mt-make39/LED_Board/部品表.xlsx

品名 | サフィックス | 型式 | 個数 | スペック | 単価 | 金額 | フットプリント | URL等
電解ｺﾝ | C1,4 | 470u 16V | 2 | 470u16V | 58 | 116 |  | https://www.digikey.jp/product-detail/ja/nichicon/UWT1C471MNL1GS/493-2181-1-ND/590156
積ｾﾗ | C2,7,9-12,14-22,24-48 | 0.1u 50V | 40 | 0.1u 50V |  | 0 | 1608
電解ｺﾝ | C3,8 | 220u 16V | 2 | 220u 16V | 43 | 86 |  | https://www.digikey.jp/product-detail/ja/nichicon/UUR1C221MCL6GS/493-6214-1-ND/3438727
積ｾﾗ | C5 | 0.01u 50V | 1 | 0.01u 50V |  | 0 | 1608
積ｾﾗ | C6 | 330p 50V | 1 | 330p 50V |  | 0 | 1608
電解ｺﾝ | C13 | 4.7u 16V | 1 | 4.7u 16V | 31 | 31 |  | https://www.digikey.jp/product-detail/ja/wurth-electronics-inc/865250340002/732-8302-1-ND/5728259
積ｾﾗ | C23 | 470p 50V | 1 | 470p 50V |  | 0 | 1608
 |  |  |  |  |  | 0
ｺﾈｸﾀ | CN1 | 2*3(6pin) 表面実装 | 1 | 2*3(6pin) | 80 | 80 |  | http://akizukidenshi.com/catalog/g/gC-06098/
microUSB | CN2 |  | 1 | microUSB | 75 | 75
 |  |  |  |  |  | 0
 |  |  |  |  |  | 0
SBD | D1,3,5,6 | RB162MM-40 | 4 |  | 54 | 216 | SDO-123F | https://www.digikey.jp/product-detail/ja/rohm-semiconductor/RB162MM-40TR/RB162MM-40CT-ND/5001882
 | D4 | RB080LAM-30TR | 1 |  | 80 | 80 | SOD-128 | https://www.digikey.jp/product-detail/ja/rohm-semiconductor/RB080LAM-30TR/RB080LAM-30CT-ND/7318362
ﾂｪﾅｰﾀﾞｲｵｰﾄﾞ | D2 | KDZVTR9.1B | 1 | Vz=9.1V | 78 | 78 | SDO-123F | https://www.digikey.jp/product-detail/ja/rohm-semiconductor/KDZVTR9.1B/KDZVTR9.1BCT-ND/4931788
 |  |  |  |  |  | 0
ﾋｭｰｽﾞ | F1 | 3413.0119.22 | 1 | 2A | 54 | 54 | 3216 | https://www.digikey.jp/product-detail/ja/schurter-inc/3413.0119.22/486-1680-1-ND/2870084
 |  |  |  |  |  | 0
DCｼﾞｬｯｸ | J1 | MJ-179PH |  | ｾﾝﾀｰﾌﾟﾗｽ | 40 | 0 |  | http://akizukidenshi.com/catalog/g/gC-06568/
3.5mmｽﾃﾚｵﾐﾆ | J2 | 3.5mm_stereo_mini_ST_005_G | 1 |  | 50 | 50 |  | http://akizukidenshi.com/catalog/g/gC-02460/
 |  |  |  |  |  | 0
ｲﾝﾀﾞｸﾀ | L1 |  |  | 33u 5A以上 | 205 | 0 |  | https://www.digikey.jp/product-detail/ja/panasonic-electronic-components/ETQ-P5M330YFC/PCD2434CT-ND/5357814
 |  |  |  |  |  | 0
ﾌﾙｶﾗｰLED | LED1-25 | WS2813B | 25 |  | 30 | 750 |  | http://akizukidenshi.com/catalog/g/gI-12405/
 |  |  |  |  |  | 0
発振器 | OSC1 | SIT2001B | 1 | 16MHz | 100 | 100 |  | http://akizukidenshi.com/catalog/g/gI-11094/
 |  |  |  |  |  | 0
FET | Q1-3 | 2SJ279STL | 3 | PMOS Vds=50V以上 | 100(@50) | 100 | DPAK(SC-63) | http://akizukidenshi.com/catalog/g/gI-08267/
ﾄﾗﾝｼﾞｽﾀ | Q4 | 2SA1313 | 1 | PNP | 100(@5) | 100 | 2915 | http://akizukidenshi.com/catalog/g/gI-05554/
ﾄﾗﾝｼﾞｽﾀ | Q5 | 2SB1203 | 1 | PNP 50V5A | 200(@40) | 200 | DPAK(SC-63) | http://akizukidenshi.com/catalog/g/gI-06602/
ﾄﾗﾝｼﾞｽﾀ | Q6 | 2SC3325 | 1 | NPN | 100(@5) | 100 | 2915 | http://akizukidenshi.com/catalog/g/gI-00628/
 |  |  |  |  |  | 0
抵抗 | R1 | 0.05 2W | 1 |  | 76 | 76 | 6432 | https://www.digikey.jp/product-detail/ja/riedon/CSR2512A0R05F/696-1669-1-ND/5723657
抵抗 | R2 | 680 1/10W | 1 |  |  | 0 | 1608
抵抗 | R3,18,27,28 | 2.2k 1/10W | 4 |  |  | 0 | 1608
抵抗 | R4 | 150 1/10W | 1 |  |  | 0 | 1608
抵抗 | R5 | 330 2W | 1 |  | 82 | 82 | 6432 | https://www.digikey.jp/product-detail/ja/te-connectivity-passive-product/3521330RFT/A116020CT-ND/4279963
抵抗 | R6 | 6.2k 1/10W | 1 |  | 30 | 30 | 1608 | https://www.digikey.jp/product-detail/ja/ERJ-PB3B6201V/P20063CT-ND/6214318/?itemSeq=270788671
抵抗 | R7,9,12,17,23,26,30,31 | 10k 1/10W R26,30,31は±0.1%以下 | 8 |  | 100(@20) | #VALUE! | 1608 | http://akizukidenshi.com/catalog/g/gR-11791/
抵抗 | R8 | 15k 1/10W | 1 |  |  | 0 | 1608
抵抗 | R10 | 47k 1/10W | 1 |  |  | 0 | 1608
抵抗 | R11 | 33k 1/10W | 1 |  | 30 | 30 | 1608 | https://www.digikey.jp/product-detail/ja/ERJ-PB3B3302V/P20143CT-ND/6214398/?itemSeq=270788572
抵抗 | R13 | 11k 1/10W | 1 |  | 30 | 30 | 1608 | https://www.digikey.jp/product-detail/ja/ERJ-PB3B1102V/P20090CT-ND/6214345/?itemSeq=270788569
抵抗 | R14,19,20,24 | 22 1/10W | 4 |  |  | 0 | 1608
抵抗 | R15 | 100k 1/10W | 1 |  |  | 0 | 1608
抵抗 | R16,32,33 | 4.7k 1/10W | 3 |  |  | 0 | 1608
抵抗 | R21 | 120k ±1%以下 1/10W | 1 |  | 14 | 14 | 1608 | https://www.digikey.jp/product-detail/ja/yageo/RT0603DRE07120KL/311-2408-1-ND/6128827
抵抗 | R22 | 130k ±1%以下 1/10W | 1 |  | 22 | 22 | 1608 | https://www.digikey.jp/product-detail/ja/yageo/RT0603DRD07130KL/311-130KDCT-ND/1035693
抵抗 | R25,29 | 20k ±1%以下 1/10W | 2 |  | 22 | 44 | 1608 | https://www.digikey.jp/product-detail/ja/yageo/RT0603DRD0720KL/311-20KDCT-ND/1035742
抵抗 | R34-58 | 220 1/10W | 25 |  |  | 0 | 1608
抵抗 | R64 | 1k ±1%以下 1/10W | 1 |  | 14 | 14 | 1608 | https://www.digikey.jp/product-detail/ja/yageo/RT0603DRE071KL/311-2475-1-ND/6128894
 |  |  |  |  |  | 0
可変抵抗 | RV1 | ST4ETB104 | 1 | 100k Bｶｰﾌﾞ | 153 | 153 |  | https://www.digikey.jp/product-detail/ja/nidec-copal-electronics/ST4ETB104/ST4ETB104CT-ND/738514
 |  |  |  |  |  | 0
ﾀｸﾄｽｲｯﾁ | SW1-2 | SKHHLPA010 | 2 |  | 10 | 20 |  | http://akizukidenshi.com/catalog/g/gP-07193/
 |  |  |  |  |  | 0
ｽｲｯﾁﾝｸﾞﾚｷﾞｭﾚｰﾀ | U1 | NJM2360 | 1 |  | 75 | 75 | SOIC-8 | https://www.digikey.jp/product-detail/ja/stmicroelectronics/MC34063ECD-TR/497-7852-1-ND/1883644
ﾁｬｰｼﾞﾎﾟﾝﾌﾟIC | U2 | MAX660 | 1 |  | 192 | 192 | SOIC-8 | https://www.digikey.jp/product-detail/ja/texas-instruments/MAX660MX-NOPB/MAX660MX-NOPBCT-ND/3527164
ﾘｾｯﾄIC | U3 | TCM809 | 1 |  | 200(@25) | 200 | SC-70(2125) | http://akizukidenshi.com/catalog/g/gI-02709/
USBｼﾘｱﾙ変換 | U4 | FT232RL | 1 |  | 400 | 400 | SSOP-28 | http://akizukidenshi.com/catalog/g/gI-01739/
ﾘﾌｧﾚﾝｽIC | U5 | NJM2825 | 1 |  | 140 | 140 | SOT-23-5(MPT5) | http://akizukidenshi.com/catalog/g/gI-08952/
ｵﾍﾟｱﾝﾌﾟ | U6-7 | NJM072B | 2 |  | 65 | 130 | SOIC-8 | https://www.digikey.jp/product-detail/ja/texas-instruments/LF353DR/296-14587-1-ND/555562
AVRﾏｲｺﾝ | U8 | ATmega328P-AU | 1 |  | 230 | 230 | TQFP-32 | http://akizukidenshi.com/catalog/g/gI-04386/
 |  |  |  |  |  | 0
 |  |  |  |  |  | 0
 |  |  |  |  |  | 0
 |  |  |  |  |  | 0
 |  |  |  |  |  | #VALUE!
