mt-make39/LED_Board/LED_Board.xlsx

Part | Footprint | Value | Number | Reference
AVR-ISP-6 |  | 3pin*2 | 1 | J2
C | C_SMD:C_1608 | 0.01u | 1 | C5
C | C_SMD:C_1608 | 0.1u | 40 | C19, C47, C31, C30, C34, C29, C28, C35, C46, C27, C26, C36, C45, C25, C24, C37, C22, C20, C21, C38, C7, C44, C39, C40, C2, C41, C14, C16, C15, C18, C32, C10, C11, C33, C43, C9, C17, C12, C42, C48
C | C_SMD:C_1608 | 330p | 1 | C6
C | C_SMD:C_1608 | 470p | 1 | C23
CP1 |  | 220u 16V | 2 | C8, C3
CP1 |  | 4.7u 16V | 1 | C13
CP1 |  | 470u 16V | 2 | C4, C1
D |  | D | 5 | D1, D4, D6, D3, D5
D_Zener |  | Vz=9.1V | 1 | D2
2SC1815 |  | npn | 1 | Q6
Q_PMOS_GDS |  | pmos | 3 | Q3, Q2, Q1
2SA1015 |  | pnp | 1 | Q4
Q_PNP_BCE |  | Icc=5A | 1 | Q5
R |  | 0.05 2W | 1 | R1
R |  | 220 2W | 1 | R5
R | R_SMD:R_1608 | 100k | 1 | R15
R | R_SMD:R_1608 | 10k | 8 | R31, R7, R17, R30, R26, R12, R9, R23
R | R_SMD:R_1608 | 110 | 1 | R4
R | R_SMD:R_1608 | 11k | 1 | R13
R | R_SMD:R_1608 | 120k | 1 | R21
R | R_SMD:R_1608 | 131k | 1 | R22
R | R_SMD:R_1608 | 15k | 1 | R8
R | R_SMD:R_1608 | 2.2k | 4 | R27, R3, R18, R28
R | R_SMD:R_1608 | 20k | 2 | R29, R25
R | R_SMD:R_1608 | 22 | 4 | R20, R14, R19, R24
R | R_SMD:R_1608 | 220 | 25 | R34, R46, R57, R35, R48, R52, R36, R45, R55, R37, R54, R53, R38, R44, R50, R39, R51, R49, R40, R43, R47, R41, R58, R56, R42
R | R_SMD:R_1608 | 33k | 1 | R11
R | R_SMD:R_1608 | 4.7k | 3 | R33, R16, R32
R | R_SMD:R_1608 | 47k | 1 | R10
R | R_SMD:R_1608 | 6.2k | 1 | R6
R | R_SMD:R_1608 | 680 | 1 | R2
R_POT |  | 100k | 1 | RV1
ATMEGA328P-A-RESCUE-LED_Board | TQFP32 | ATMEGA328P-A | 1 | U?
FT232RL |  | FT232RL | 1 | U4
F_Small |  | 2A | 1 | F1
SW_PUSH |  | SW_PUSH | 1 | SW1
WS2813 |  | WS2813 | 25 | LED14, LED1, LED10, LED15, LED8, LED25, LED16, LED11, LED7, LED17, LED6, LED12, LED9, LED24, LED5, LED19, LED23, LED4, LED20, LED13, LED3, LED21, LED2, LED22, LED18
SIT2001B |  | 16MHz | 1 | OSC1
MAX660 |  | MAX660 | 1 | U2
NJM2360 |  | NJM2360 | 1 | U1
TCM809 |  | TCM809 | 1 | U3
NJM2825 |  | NJM2825 | 1 | U5
3.5mm_stereo_mini_ST_005_G |  | 3.5mm_stereo_mini_ST_005_G | 1 | J3
BARREL_JACK |  | BARREL_JACK | 1 | J1
USB_OTG |  | microUSB | 1 | P1
NJM072 |  | NJM072 | 2 | U6, U7
INDUCTOR |  | 33u 5A | 1 | L1
