mt-make39/LED_Board/LED_Board.pdf

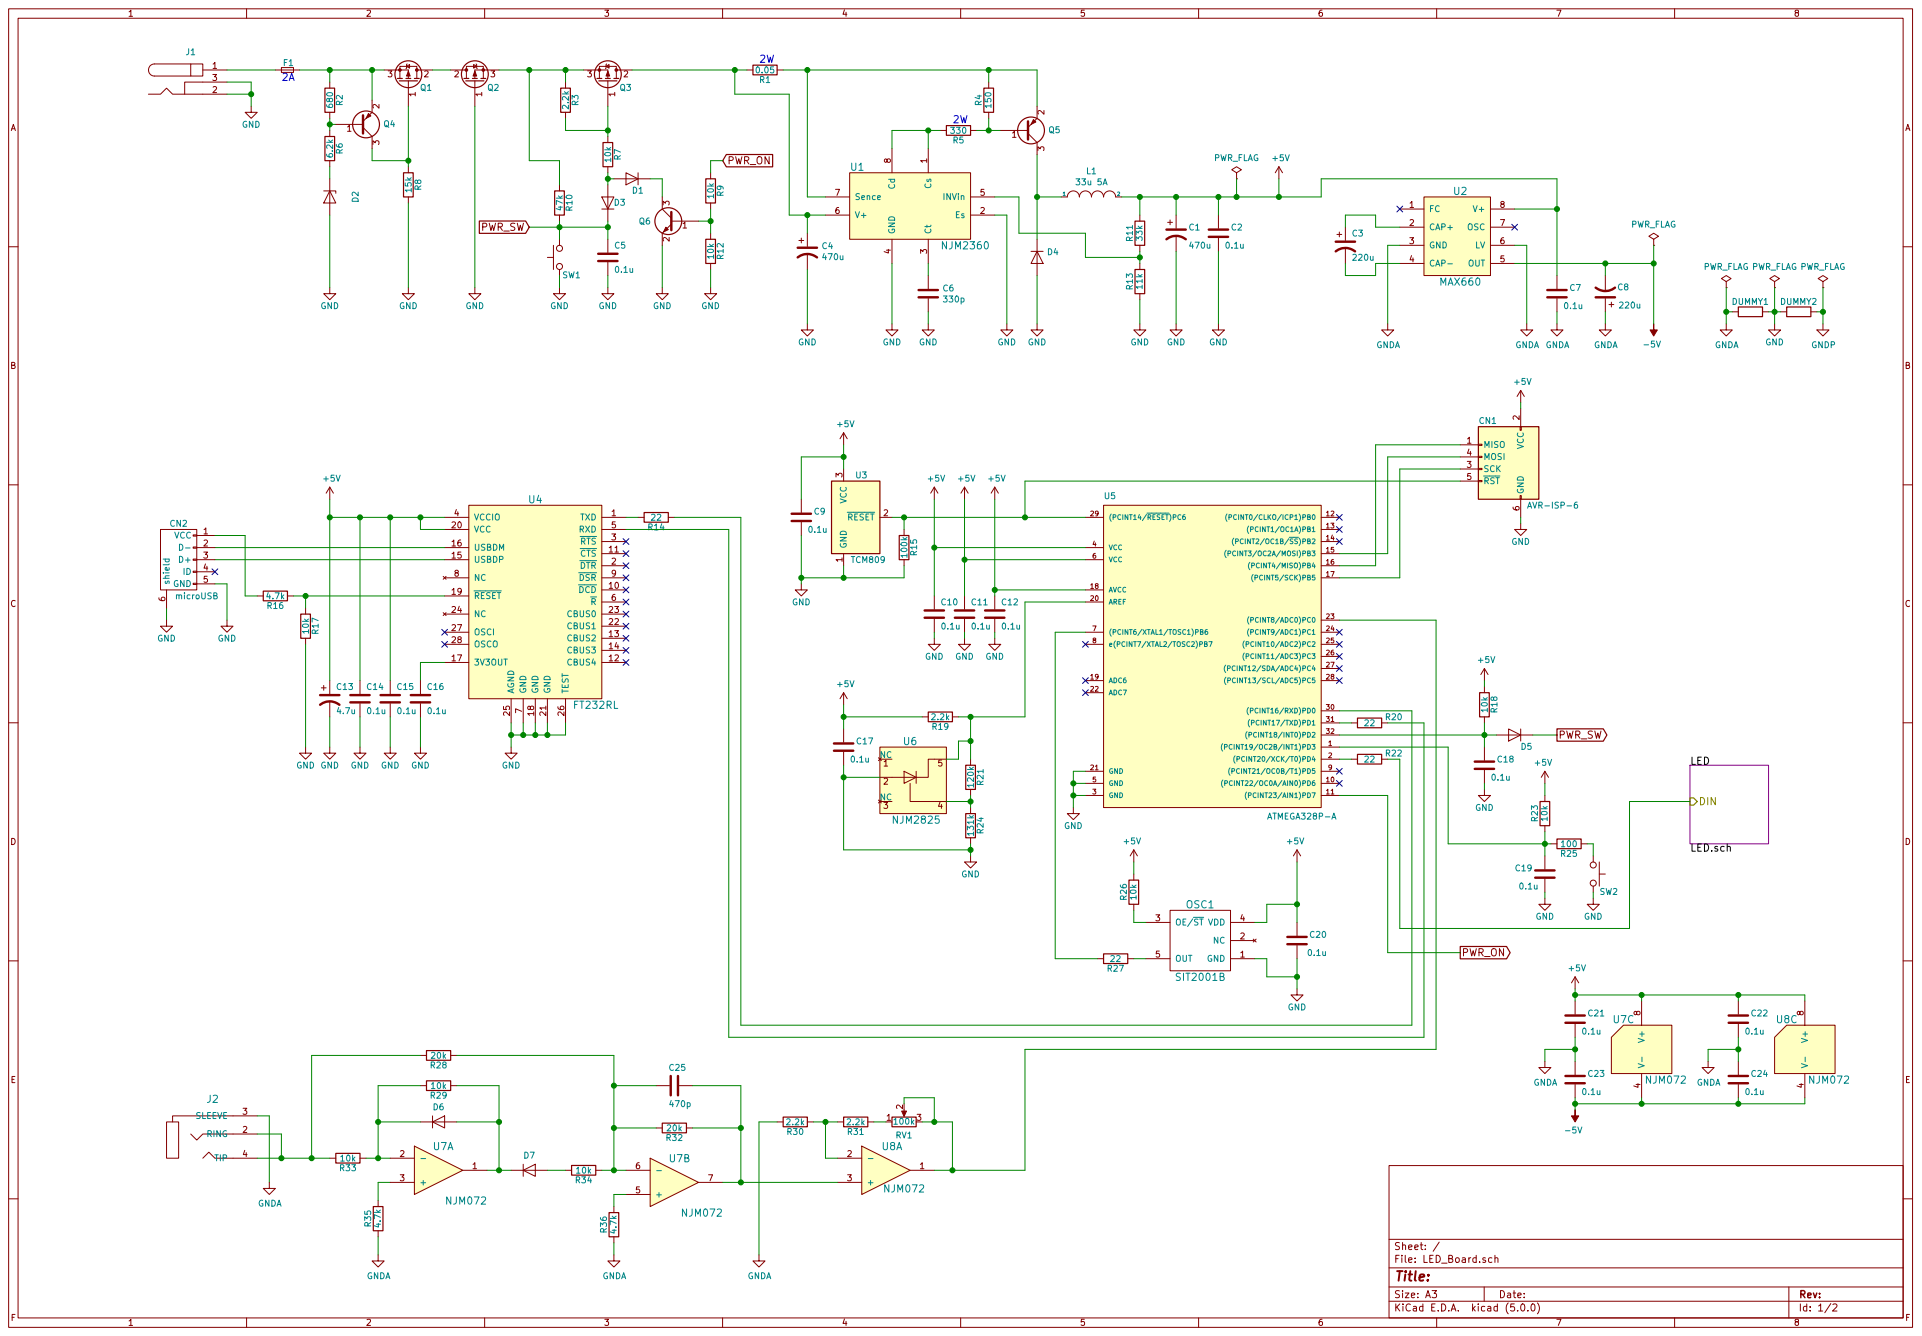
[picture p1: page 1]

2 SCK 3 MOSI 4 RST 5 GND

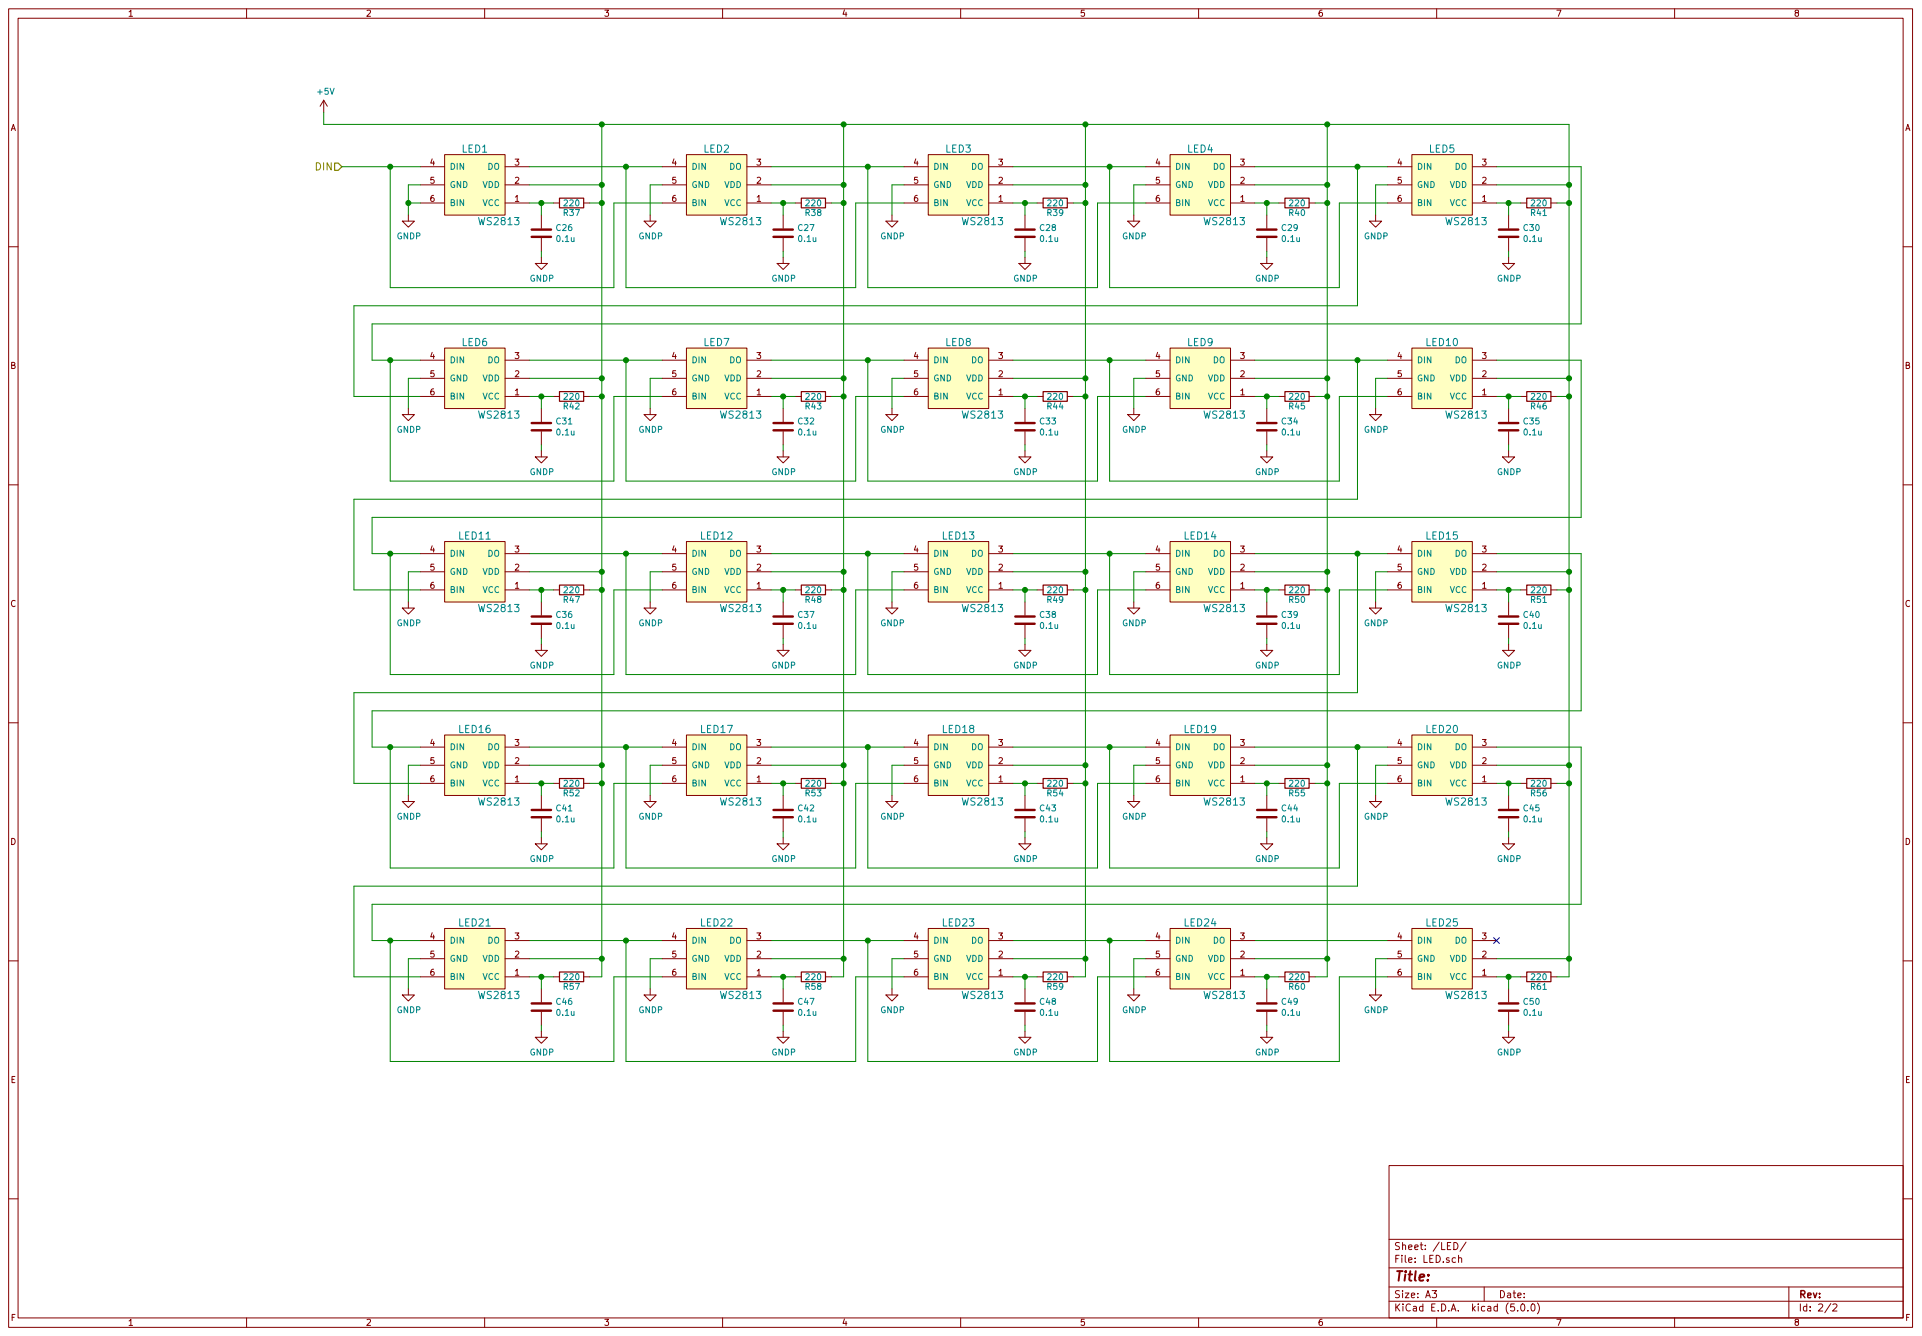
[picture p2: page 2]

Id: 2/2 Title: File: LED.sch Sheet: /LED/
