mt-make39/LED_Board/LED_Board.kicad_pcb

## KiCad design LED_Board.kicad_pcb (2019-01-29)

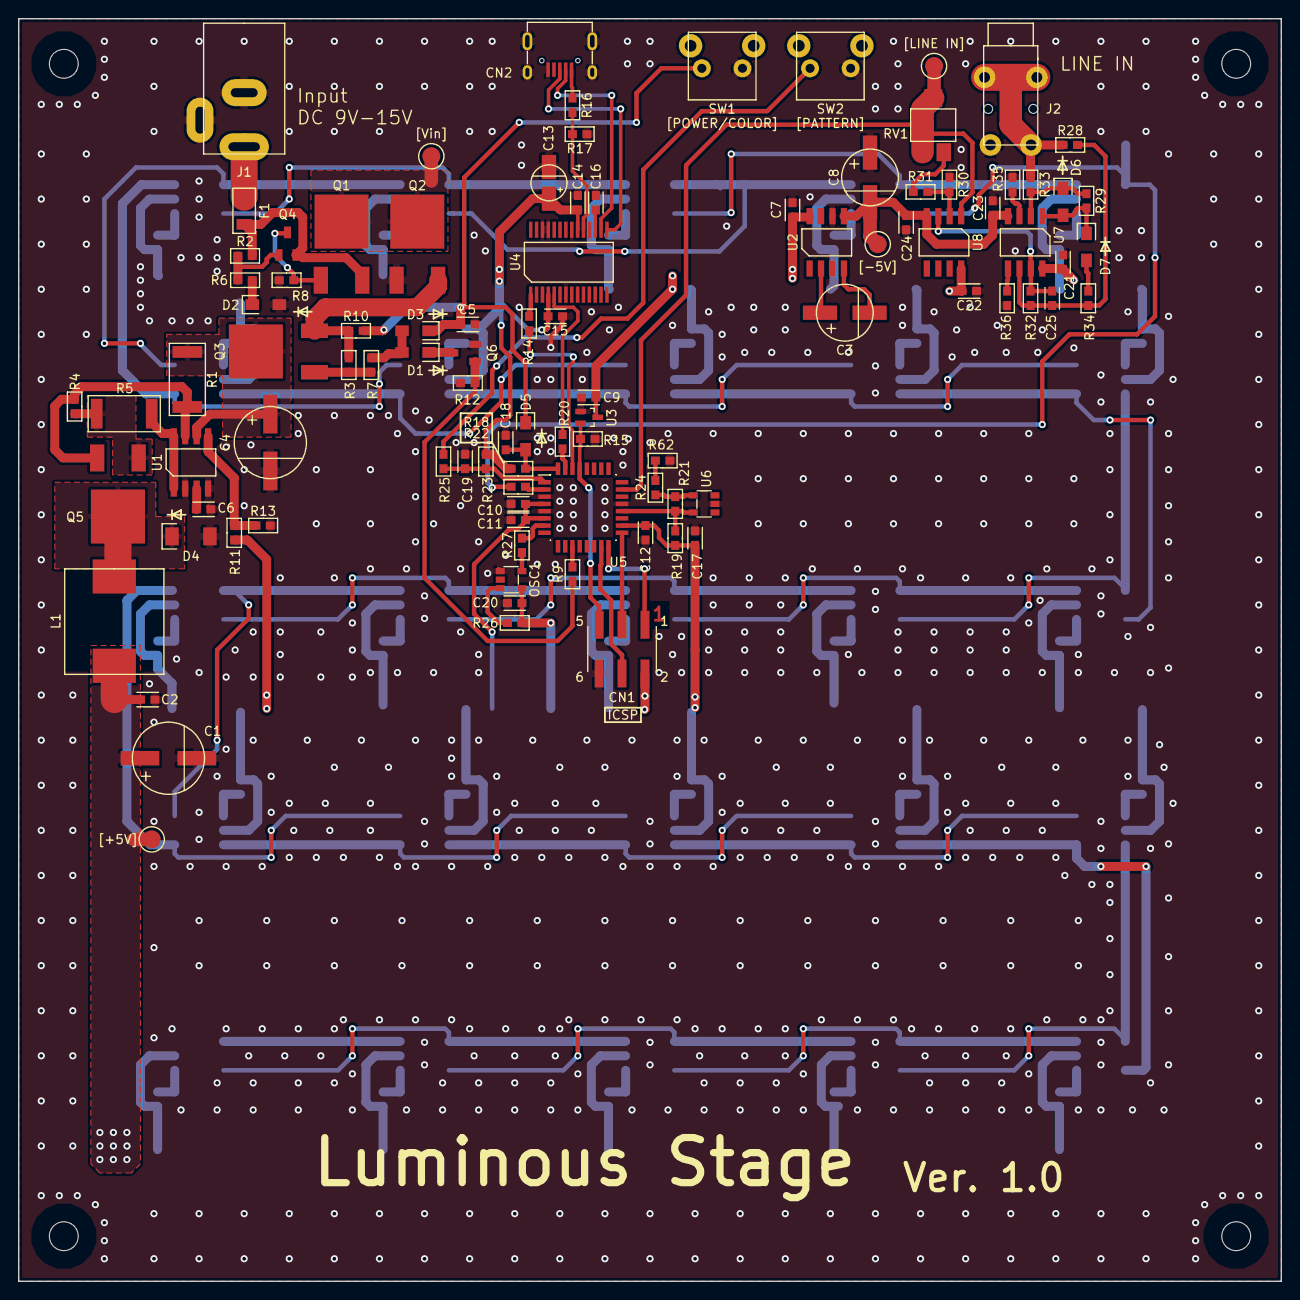
[picture p3: board LED_Board.kicad_pcb from above]

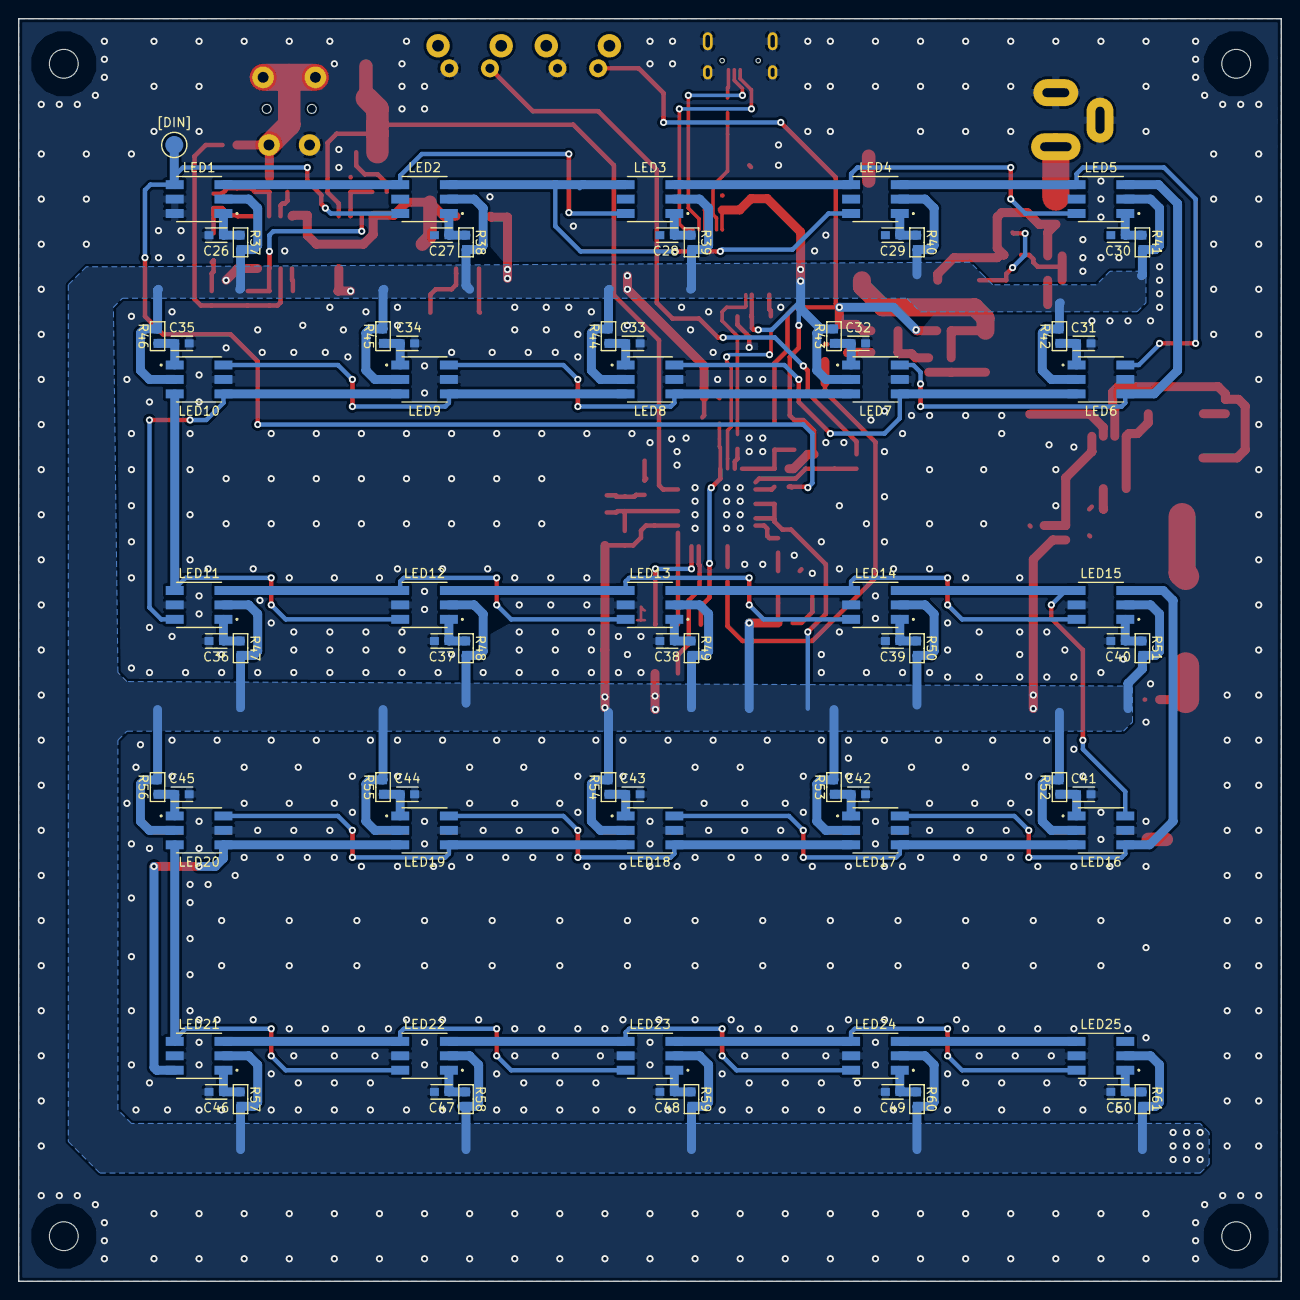
[picture p4: board LED_Board.kicad_pcb from below]

Board: 2 copper layers, 140.0 x 140.0 mm, 168 parts (75 on the bottom side), 109 nets.

Parts:
C1, C4: 470u; Φ8mm
C2, C5, C7, C9, C10, C11, C12, C14, C15, C16, C17, C18, C19, C20, C21, C22, C23, C24, C26, C27, C28, C29, C30, C31, C32, C33, C34, C35, C36, C37, C38, C39, C40, C41, C42, C43, C44, C45, C46, C47, C48, C49, C50: 0.1u; C_1608
C3, C8: 220u; Φ6.3mm
C6: 330p; C_1608
C13: 4.7u; Φ4mm
C25: 470p; C_1608
CN1: AVR-ISP-6; 2×3(6pin)_SMD
CN2: microUSB; microUSB(U-F-M5DD-W-2)
D1, D3, D5, D6, D7: D; SOD-123FL
D2: D_Zener; SOD-123FL
D4: D; SOD-128
F1: F_Small; R_3216
J1: BARREL_JACK; MJ-179PH
J2: 3.5mm_stereo_mini_ST_005_G; STEREO_MINI_35
L1: 33u 5A; ETQ-P5MxxxYFC
LED1, LED2, LED3, LED4, LED5, LED6, LED7, LED8, LED9, LED10, LED11, LED12, LED13, LED14, LED15, LED16, LED17, LED18, LED19, LED20, LED21, LED22, LED23, LED24, LED25: WS2813
OSC1: SIT2001B; SOT-23-5(MTP5)
Q1, Q2, Q3: Q_PMOS_GDS; D-PAK(SC-63)
Q4: Q_PNP_BEC; TO-236MOD(SC-59)
Q5: Q_PNP_BCE; D-PAK(SC-63)
Q6: Q_NPN_BEC; TO-236MOD(SC-59)
R1: 0.05; R_6432
R2: 680; R_1608
R3, R19, R30, R31: 2.2k; R_1608
R4: 150; R_1608
R5: 330; R_6432
R6: 6.2k; R_1608
R7, R9, R12, R17, R18, R23, R26, R29, R33, R34: 10k; R_1608
R8: 15k; R_1608
R10: 47k; R_1608
R11: 33k; R_1608
R13: 11k; R_1608
R14, R20, R22, R27: 22; R_1608
R15: 100k; R_1608
R16, R35, R36: 4.7k; R_1608
R21: 120k; R_1608
R24: 130k; R_1608
R25: 100; R_1608
R28, R32: 20k; R_1608
R37, R38, R39, R40, R41, R42, R43, R44, R45, R46, R47, R48, R49, R50, R51, R52, R53, R54, R55, R56, R57, R58, R59, R60, R61: 220; R_1608
R62: 1k; R_1608
RV1: 100k; ST-4EB
SW1, SW2: SW_PUSH; SKHHLPA010
U1: NJM2360; SOP-8pin
U2: MAX660; SOP-8pin
U3: TCM809; SC-70
U4: FT232RL; SSOP_28pin
U5: ATMEGA328P-A; QFP_0.8_32pin
U6: NJM2825; SOT-23-5(MTP5)
U7, U8: NJM072; SOP-8pin

Connections:
+5V: C1.1, C2.1, C7.1, C9.1, C10.1, C11.1, C12.1, C13.1, C14.1, C15.1, C17.1, C20.1, C21.1, C22.1, CN1.2, L1.2, LED1.2, LED2.2, LED3.2, LED4.2, LED5.2, LED6.2, LED7.2, LED8.2, LED9.2, LED10.2, LED11.2, LED12.2, LED13.2, LED14.2, LED15.2, LED16.2, LED17.2, LED18.2, LED19.2, LED20.2, LED21.2, LED22.2, LED23.2, LED24.2, LED25.2, OSC1.4, R11.2, R18.1, R19.2, R23.1, R26.1, R37.1, R38.1, R39.1, R40.1, R41.1, R42.1, R43.1, R44.1, R45.1, R46.1, R47.1, R48.1, R49.1, R50.1, R51.1, R52.1, R53.1, R54.1, R55.1, R56.1, R57.1, R58.1, R59.1, R60.1, R61.1, U2.8, U3.3, U4.4, U4.20, U5.4, U5.6, U5.18, U7.8, U8.8
-5V: C8.2, C23.2, C24.2, U2.5, U7.4, U8.4
/LED/DIN: LED1.4, LED2.6, R22.1
GND: C1.2, C2.2, C4.2, C5.2, C6.2, C7.2, C8.1, C9.2, C10.2, C11.2, C12.2, C13.2, C14.2, C15.2, C16.2, C17.2, C18.2, C19.2, C20.2, C21.2, C22.2, C23.1, C24.1, C26.2, C31.2, C32.2, C33.2, C34.2, C35.2, C36.2, C37.2, C38.2, C39.2, C40.2, C41.2, C42.2, C43.2, C44.2, C45.2, C46.2, C47.2, C48.2, C49.2, C50.2, CN1.6, CN2.5, CN2.6, D2.2, D4.2, J1.2, J1.3, J2.3, LED1.5, LED1.6, LED6.5, LED7.5, LED8.5, LED9.5, LED10.5, LED11.5, LED12.5, LED13.5, LED14.5, LED15.5, LED16.5, LED17.5, LED18.5, LED19.5, LED20.5, LED21.5, LED22.5, LED23.5, LED24.5, LED25.5, OSC1.1, Q2.1, Q6.2, R8.2, R12.2, R13.1, R15.2, R17.2, R30.2, R35.1, R36.1, R62.2, SW1.1, SW2.1, U1.2, U1.4, U2.3, U2.6, U3.1, U4.7, U4.18, U4.21, U4.25, U4.26, U5.3, U5.5, U5.21, U6.2
unnamed: C3.1, U2.2
unnamed: C3.2, U2.4
unnamed: C4.1, Q3.2, R1.2, U1.6
unnamed: C6.1, U1.3
unnamed: C16.1, U4.17
unnamed: C18.1, D5.2, R18.2, U5.32
unnamed: C19.1, R23.2, R25.1, U5.1
unnamed: C25.1, R32.1, U7.7, U8.3
unnamed: C25.2, R28.1, R32.2, R34.1, U7.6
unnamed: C26.1, LED1.1, R37.2
unnamed: C27.1, LED2.1, R38.2
unnamed: C28.1, LED3.1, R39.2
unnamed: C29.1, LED4.1, R40.2
unnamed: C30.1, LED5.1, R41.2
unnamed: C31.1, LED6.1, R42.2
unnamed: C32.1, LED7.1, R43.2
unnamed: C33.1, LED8.1, R44.2
unnamed: C34.1, LED9.1, R45.2
unnamed: C35.1, LED10.1, R46.2
unnamed: C36.1, LED11.1, R47.2
unnamed: C37.1, LED12.1, R48.2
unnamed: C38.1, LED13.1, R49.2
unnamed: C39.1, LED14.1, R50.2
unnamed: C40.1, LED15.1, R51.2
unnamed: C41.1, LED16.1, R52.2
unnamed: C42.1, LED17.1, R53.2
unnamed: C43.1, LED18.1, R54.2
unnamed: C44.1, LED19.1, R55.2
unnamed: C45.1, LED20.1, R56.2
unnamed: C46.1, LED21.1, R57.2
unnamed: C47.1, LED22.1, R58.2
unnamed: C48.1, LED23.1, R59.2
unnamed: C49.1, LED24.1, R60.2
unnamed: C50.1, LED25.1, R61.2
unnamed: CN1.1, U5.16
unnamed: CN1.3, U5.17
unnamed: CN1.4, U5.15
unnamed: CN1.5, R15.1, U3.2, U5.29
unnamed: CN2.1, R16.2
unnamed: CN2.2, U4.16
unnamed: CN2.3, U4.15
unnamed: D1.1, Q6.3
unnamed: D1.2, D3.2, R7.2
unnamed: D2.1, R6.2
unnamed: D4.1, L1.1, Q5.2
unnamed: D6.1, R29.2, R33.1, U7.2
unnamed: D6.2, D7.1, R29.1, U7.1
unnamed: D7.2, R34.2
unnamed: F1.1, J1.1
unnamed: F1.2, Q1.3, Q4.2, R2.1
unnamed: J2.2, J2.4, R28.2, R33.2
unnamed: LED1.3, LED2.4, LED3.6
unnamed: LED2.3, LED3.4, LED4.6
unnamed: LED3.3, LED4.4, LED5.6
unnamed: LED4.3, LED5.4, LED6.6
unnamed: LED5.3, LED6.4, LED7.6
unnamed: LED6.3, LED7.4, LED8.6
unnamed: LED7.3, LED8.4, LED9.6
unnamed: LED10.3, LED11.4, LED12.6
unnamed: LED9.3, LED10.4, LED11.6
unnamed: LED8.3, LED9.4, LED10.6
unnamed: LED11.3, LED12.4, LED13.6
unnamed: LED12.3, LED13.4, LED14.6
unnamed: LED13.3, LED14.4, LED15.6
unnamed: LED14.3, LED15.4, LED16.6
unnamed: LED15.3, LED16.4, LED17.6
unnamed: LED16.3, LED17.4, LED18.6
unnamed: LED17.3, LED18.4, LED19.6
unnamed: LED18.3, LED19.4, LED20.6
unnamed: LED19.3, LED20.4, LED21.6
unnamed: LED20.3, LED21.4, LED22.6
unnamed: LED21.3, LED22.4, LED23.6
unnamed: LED22.3, LED23.4, LED24.6
unnamed: LED23.3, LED24.4, LED25.6
unnamed: LED24.3, LED25.4
unnamed: OSC1.3, R26.2
unnamed: OSC1.5, R27.2
unnamed: Q1.1, Q4.3, R8.1
unnamed: Q1.2, Q2.2
unnamed: Q2.3, Q3.3, R3.1, R10.1
unnamed: Q3.1, R3.2, R7.1
unnamed: Q4.1, R2.2, R6.1
unnamed: Q5.1, R4.1, R5.1
unnamed: Q5.3, R1.1, R4.2, U1.7
unnamed: Q6.1, R9.2, R12.1
unnamed: R5.2, U1.1, U1.8
unnamed: R11.1, R13.2, U1.5
unnamed: R14.1, U5.30
unnamed: R14.2, U4.1
unnamed: R16.1, R17.1, U4.19
unnamed: R19.1, R21.1, U5.20, U6.5
unnamed: R20.1, U4.5
unnamed: R20.2, U5.31
unnamed: R21.2, R24.1, U6.4
unnamed: R22.2, U5.2
unnamed: R24.2, R62.1
unnamed: R25.2, SW2.2
unnamed: R27.1, U5.7
unnamed: R30.1, R31.2, U8.2
unnamed: R31.1, RV1.1
unnamed: R35.2, U7.3
unnamed: R36.2, U7.5
unnamed: RV1.2, RV1.3, U5.23, U8.1
PWR_ON: R9.1, U5.11
PWR_SW: C5.1, D3.1, D5.1, R10.2, SW1.2
